jonathanliyou0623-wq/smart-package-detector/firmware/real_sensor_dashboard/secrets.example.h

#pragma once

// Copy this file to secrets.h and replace the placeholders locally.
// Never commit secrets.h.
constexpr char WIFI_SSID[] = "YOUR_WIFI_NAME";
constexpr char WIFI_PASSWORD[] = "YOUR_WIFI_PASSWORD";
