jonathanliyou0623-wq/smart-package-detector/(commit log)

2026-09-04 feat: add ESP32 package detection prototype
2026-09-04 fix: use correct Arduino library name in CI
2026-09-08 feat: add ESP32 simulation milestone
2026-09-21 feat: add real sensor dashboard milestone
2026-09-22 feat: export timestamped sensor samples as CSV
2026-09-24 docs: record labeled sensor timing trial
2026-10-08 feat: isolate sensor sampling from HTTP load
